calebhylkema/fusion-tracker/docs/nucleo-f446re/pinout.png

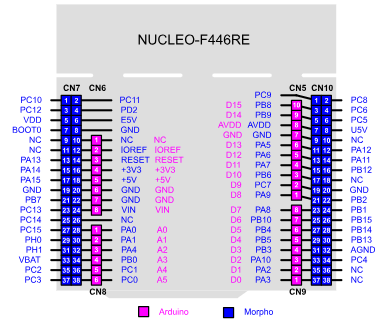
docs/nucleo-f446re/pinout.png
