calebhylkema/fusion-tracker/docs/parts/cam.png

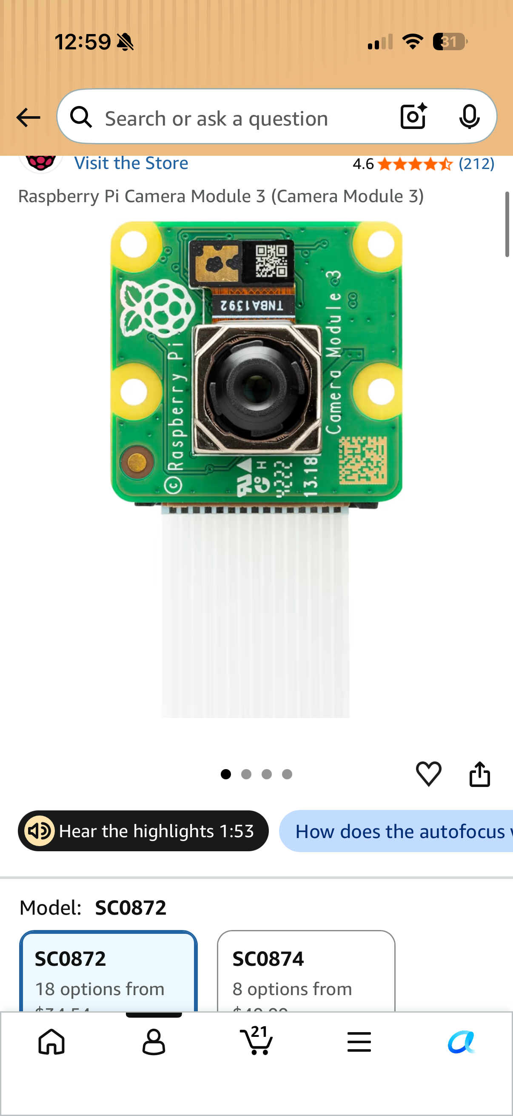
docs/parts/cam.png
