calebhylkema/fusion-tracker/docs/parts/cantx.png

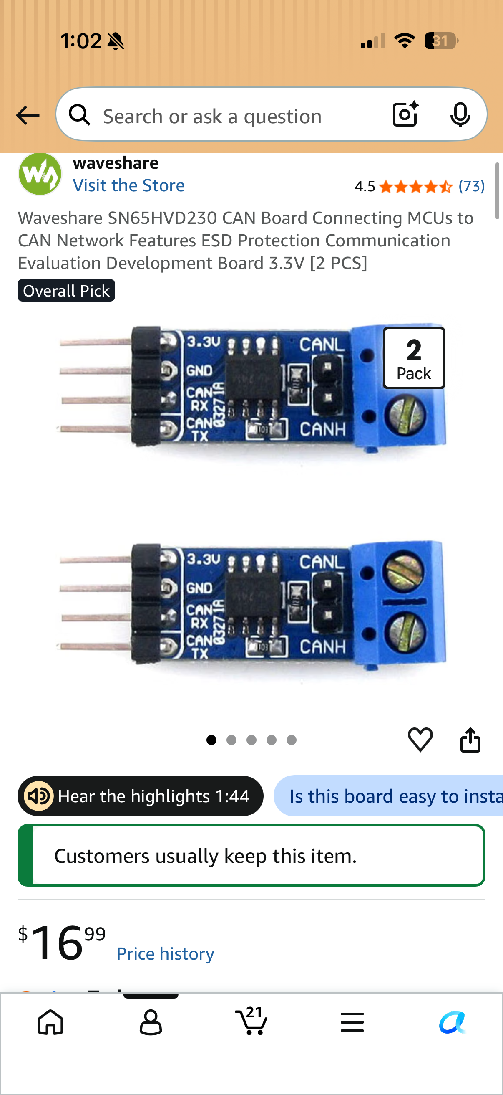
docs/parts/cantx.png
