calebhylkema/fusion-tracker/docs/parts/imu.png

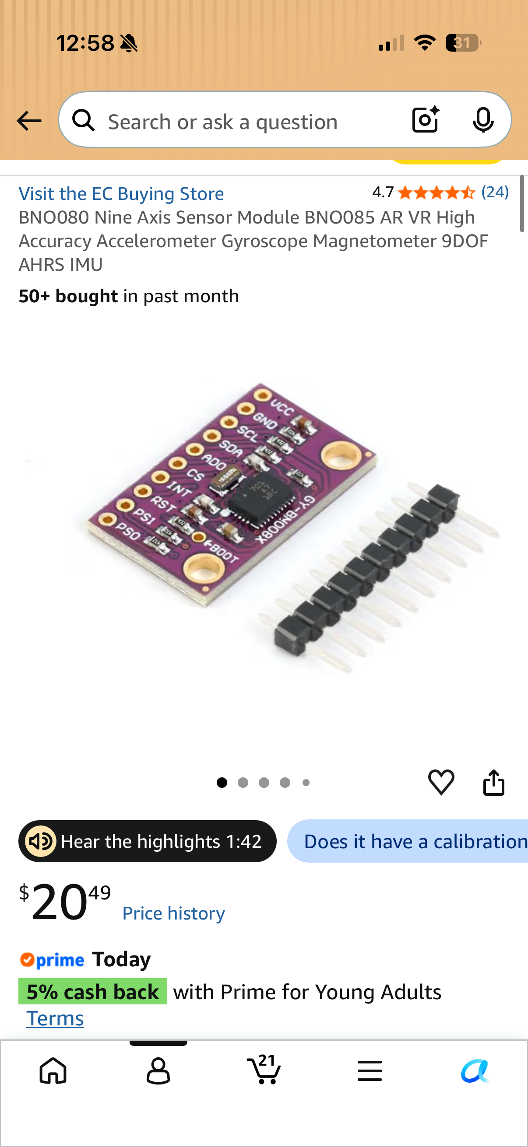
docs/parts/imu.png
