calebhylkema/fusion-tracker/docs/parts/mcu.png

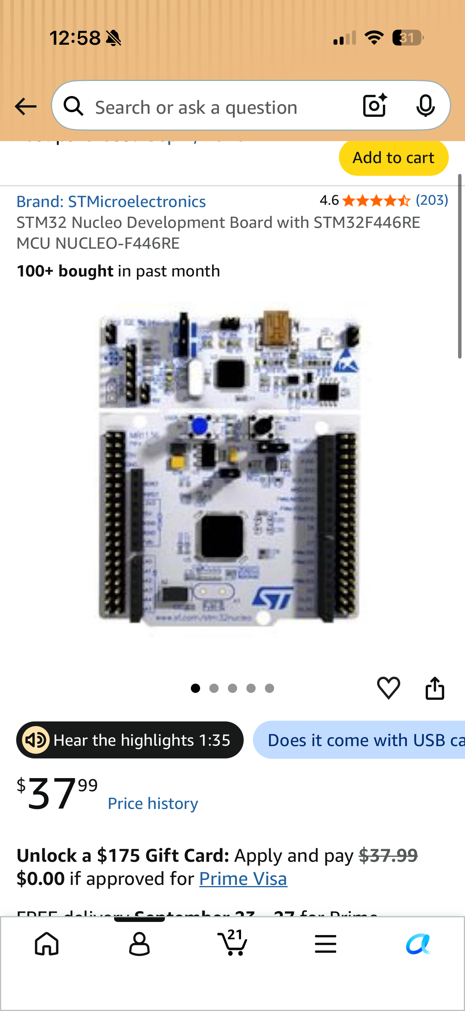
docs/parts/mcu.png
