calebhylkema/fusion-tracker/docs/parts/radar.png

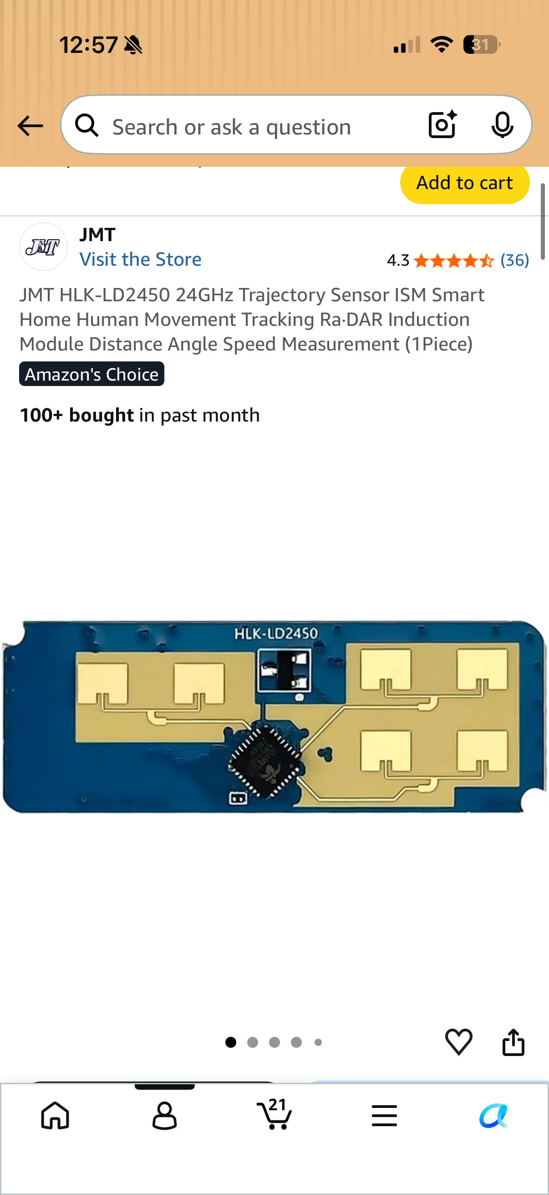
docs/parts/radar.png
