calebhylkema/fusion-tracker/docs/parts/rp5.png

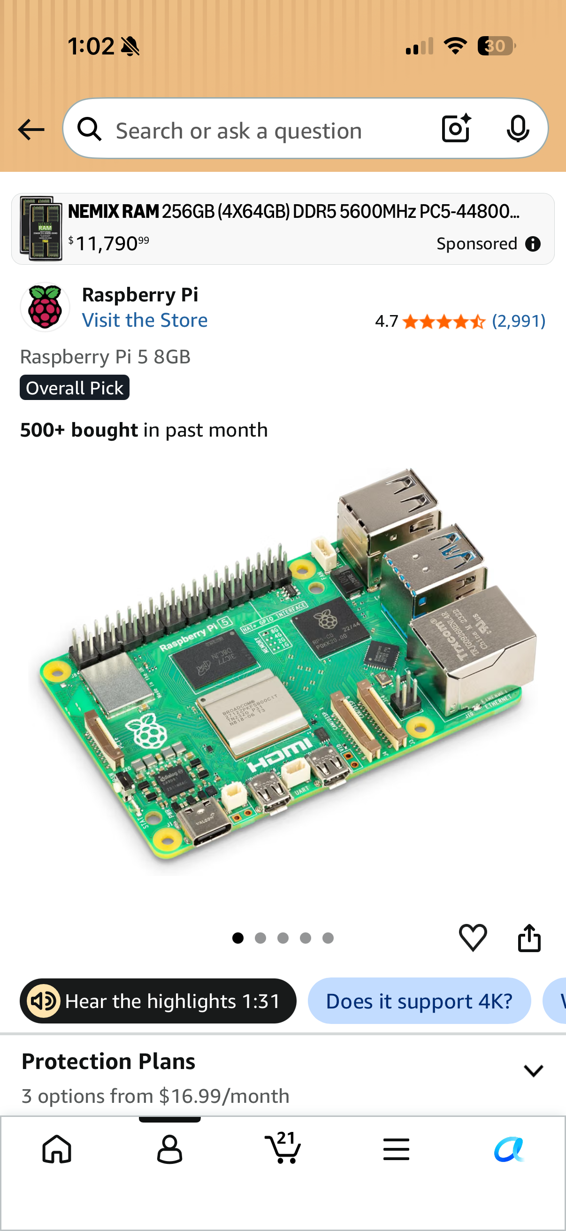
docs/parts/rp5.png
