calebhylkema/fusion-tracker/docs/parts/ttladapter.png

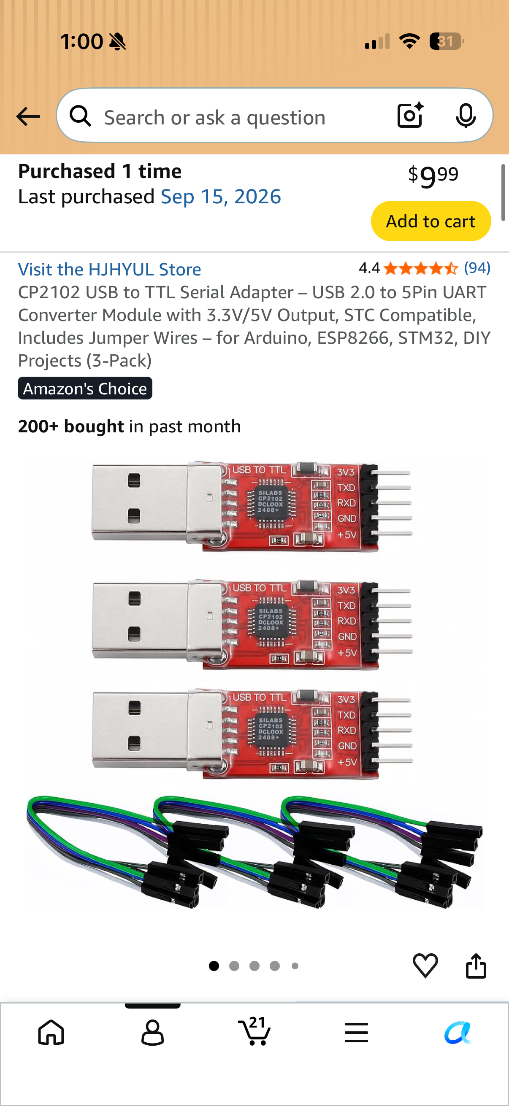
docs/parts/ttladapter.png
