calebhylkema/fusion-tracker/firmware/fusion_tracker_fw/Core/Src/main.c

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
/* Includes ------------------------------------------------------------------*/
#include "main.h"

/* USER CODE BEGIN Includes */

#include <stdio.h>
#include "ld2450.h"
#include "bno085.h"
#include "can_bus.h"
#include "fusion.h"
#include "camera_link.h"

/* USER CODE END Includes */

CAN_HandleTypeDef hcan1;

UART_HandleTypeDef huart1;
UART_HandleTypeDef huart2;
UART_HandleTypeDef huart3;
UART_HandleTypeDef huart6;
DMA_HandleTypeDef hdma_usart1_rx;
DMA_HandleTypeDef hdma_usart3_rx;
DMA_HandleTypeDef hdma_usart6_rx;

void SystemClock_Config(void);
static void MX_GPIO_Init(void);
static void MX_DMA_Init(void);
static void MX_USART2_UART_Init(void);
static void MX_USART1_UART_Init(void);
static void MX_USART3_UART_Init(void);
static void MX_CAN1_Init(void);
static void MX_USART6_UART_Init(void);
/* USER CODE BEGIN 0 */

/* Machine-readable telemetry line for the laptop dashboard:
 * TEL,r0x,r0y,r0ok,r1x,r1y,r1ok,r2x,r2y,r2ok,yawdeg,camdeg,camok,fpxcm,fpycm,fvxcm,fvycm,fok
 * radar x/y in mm; yaw/cam in deg; fused px/py/vx/vy in cm; ok flags 0/1. */
static void telemetry_print(const ld2450_frame_t *r, int16_t yaw_cd,
                            const camera_det_t *cam, const fused_track_t *ft)
{
  printf("TEL");
  for (int t = 0; t < LD2450_MAX_TARGETS; t++)
    printf(",%d,%d,%d", r->target[t].x, r->target[t].y, r->target[t].valid ? 1 : 0);
  printf(",%d,%d,%d", yaw_cd / 100,
         (int)(cam->bearing_rad * 57.2958f), cam->present ? 1 : 0);
  printf(",%d,%d,%d,%d,%d,%lu\r\n",
         (int)(ft->px * 100), (int)(ft->py * 100),
         (int)(ft->vx * 100), (int)(ft->vy * 100), ft->valid ? 1 : 0,
         (unsigned long)camera_rx_bytes());
}

/* USER CODE END 0 */

/**
  * @brief  The application entry point.
  * @retval int
  */
int main(void)
{

  /* MCU Configuration--------------------------------------------------------*/

  /* Reset of all peripherals, Initializes the Flash interface and the Systick. */
  HAL_Init();

  /* Configure the system clock */
  SystemClock_Config();

  /* Initialize all configured peripherals */
  MX_GPIO_Init();
  MX_DMA_Init();
  MX_USART2_UART_Init();
  MX_USART1_UART_Init();
  MX_USART3_UART_Init();
  MX_CAN1_Init();
  MX_USART6_UART_Init();
  /* USER CODE BEGIN 2 */

  setvbuf(stdout, NULL, _IONBF, 0);
  printf("\r\nFusion Tracker booting @ 180 MHz\r\n");
  printf("USART1 radar RX @ 256000...\r\n");
  ld2450_init(&huart1);
  printf("USART3 IMU (BNO085 UART-RVC) @ 115200...\r\n");
  bno085_init(&huart3);
  printf("CAN1 @ 500 kbit/s (loopback self-test)...\r\n");
  can_bus_init(&hcan1);
  printf("EKF fusion (radar + IMU yaw) online\r\n");
  fusion_init();
  printf("USART6 camera link (from Pi) @ 115200...\r\n");
  camera_init(&huart6);

  /* USER CODE END 2 */

  /* Infinite loop */
  /* USER CODE BEGIN WHILE */
  while (1)
  {
    /* USER CODE END WHILE */

    /* USER CODE BEGIN 3 */

    static ld2450_frame_t last_radar;
    static bno085_frame_t last_imu;
    static uint32_t last_print = 0;

    ld2450_frame_t frame;
    static uint32_t radar_tick = 0;
    while (ld2450_process(&frame)) {
      last_radar = frame;
      uint32_t now = HAL_GetTick();
      float dt = radar_tick ? (now - radar_tick) * 0.001f : 0.1f;
      radar_tick = now;
      float yaw = last_imu.yaw * (0.01f * 3.14159265f / 180.0f);  /* centideg -> rad */
      fusion_step(&frame, yaw, dt);
    }

    bno085_frame_t imu;
    while (bno085_process(&imu)) last_imu = imu;          /* keep newest IMU frame */

    static camera_det_t last_cam = {0};
    camera_det_t cam;
    while (camera_process(&cam)) {
      last_cam = cam;
      if (cam.present) {
        float yaw = last_imu.yaw * (0.01f * 3.14159265f / 180.0f);
        fusion_update_camera(cam.bearing_rad + yaw);      /* fuse camera bearing */
      }
    }

    if (HAL_GetTick() - last_print >= 100) {              /* 10 Hz telemetry */
      last_print = HAL_GetTick();
      fused_track_t ft = fusion_track();
      telemetry_print(&last_radar, last_imu.yaw, &last_cam, &ft);

      /* CAN loopback (proven) — kept alive but quieted so the console is readable.
       * Next step: broadcast the real fused track here instead. */
      static uint8_t can_ctr = 0;
      uint8_t tx[8] = { can_ctr++, 0xDE, 0xAD, 0xBE, 0xEF, 0, 0, 0 };
      can_bus_send(0x1F0, tx, 5);
      uint32_t rid; uint8_t rx[8], rlen;
      can_bus_poll(&rid, rx, &rlen);       /* drain FIFO, don't print */
    }
  }
  /* USER CODE END 3 */
}

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
/* USER CODE BEGIN 4 */

int __io_putchar(int ch)
{
  HAL_UART_Transmit(&huart2, (uint8_t *)&ch, 1, HAL_MAX_DELAY);
  return ch;
}

void HAL_UARTEx_RxEventCallback(UART_HandleTypeDef *huart, uint16_t Size)
{
  if (huart->Instance == USART1)
    ld2450_rx_event(Size);
  else if (huart->Instance == USART3)
    bno085_rx_event(Size);
  else if (huart->Instance == USART6)
    camera_rx_event(Size);
}

void HAL_UART_ErrorCallback(UART_HandleTypeDef *huart)
{
  if (huart->Instance == USART1)
    ld2450_error_isr();
  else if (huart->Instance == USART3)
    bno085_error_isr();
  else if (huart->Instance == USART6)
    camera_error_isr();
}

/* USER CODE END 4 */
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
