calebhylkema/fusion-tracker/(commit log)

2026-09-18 Scaffold fusion-tracker repo (Phase 0)
    Repo skeleton, refined spec, requirements + V&V matrix, and setup checklist.
    V1 = LD2450 + camera + IMU fusion (hand-written EKF/IMM); raw-radar swap deferred to V2.
2026-09-19 Add STM32 firmware: Nucleo bringup through radar RX
    - CubeMX/HAL project for NUCLEO-F446RE (180 MHz clock tree)
    - printf retargeted to USART2 (ST-LINK VCP) for debug console
    - USART1 @ 256000 for HLK-LD2450 radar; interrupt RX into ring buffer
    - Confirmed live radar frames (AA FF 03 00 ... 55 CC) on hardware
    - Add NUCLEO-F446RE pinout reference under docs/
2026-09-19 Add LD2450 frame parser with decoded target output
    - Sync on AA FF 03 00 header, validate 55 CC tail (30-byte frame)
    - Sign-magnitude decode of X/Y/speed; matches RBEGamer/HLK-LD2450 reference
    - Per-target output: ID, X, Y, speed, resolution, distance (integer sqrt), valid
    - Ring-buffer fed byte-by-byte from the USART1 RX interrupt
2026-09-19 Refactor radar into reusable ld2450 driver module
    - New Core/{Inc,Src}/ld2450.{h,c}: ring-buffer RX, header-synced parser,
    typed ld2450_frame_t / ld2450_target_t output API
    - main.c now just ld2450_init() + ld2450_process() drain loop, forwards ISRs
    - Behavior unchanged; sets up frame consumption for the EKF later
2026-09-20 Switch radar RX to DMA + idle-line (ReceiveToIdle_DMA)
    - USART1_RX on DMA2 Stream 2; frame delivered per idle event instead of
    one interrupt per byte (~10/s vs ~25,600/s), freeing the CPU for the EKF
    - Driver: ld2450_rx_event() drains the DMA buffer into the ring buffer,
    re-arms; HAL_UARTEx_RxEventCallback forwards from main.c
    - Behavior unchanged; more robust against CPU-busy byte drops
2026-09-21 Add BNO085 IMU (UART-RVC) driver and unified status dashboard
    - New Core/{Inc,Src}/bno085.{h,c}: UART-RVC parser (0xAA 0xAA framing,
    checksum), DMA+idle RX on USART3, yaw/pitch/roll + accel via bno085_frame_t
    - main.c: init both sensors, drain each to latest frame, print one aligned
    fixed-width status line at 5 Hz (IMU angles + 3 radar slots)
    - Three sensors live: radar (10 Hz) + IMU (100 Hz) on one console line
    [bno085.c, bno085.h, fusion_tracker_fw.ioc, main.c]
2026-09-27 Add EKF fusion sim with NEES/NIS validation
    - sim/ekf.py: reference EKF (linear radar + nonlinear camera-bearing update)
    - sim/run_fusion.py: Monte-Carlo scenario, radar-only vs fused RMSE, NEES/NIS
    consistency vs chi-square bounds, trajectory + NEES plots
    - Result: fusion cuts position RMSE 35% (0.218 -> 0.141 m); NEES=3.99/NIS=2.00
    (consistent). Q tuned to 0.2 via the NEES loop.
2026-09-27 Add IMM estimator (CV + coordinated-turn) for maneuvering targets
    - sim/imm.py: IMM with mixing, per-model EKF filtering, mode-probability update,
    moment-matched combination; CV + CT-left + CT-right models
    - sim/ekf.py: generalized to accept arbitrary F/Q (for CT models)
    - sim/run_imm.py: straight->turn->straight scenario, single-CV vs IMM
    - Result: IMM 13% better position RMSE during the turn; mode probs correctly
    switch to the turn model in the maneuver
2026-09-27 Add live (real-time) sim viewers for EKF and IMM
    - sim/live_fusion.py: animated EKF fusion — target, radar measurements,
    radar-only vs fused estimate, 2-sigma covariance ellipse, live error readout
    - sim/live_imm.py: animated IMM — maneuvering target + live mode-probability bars
    - TkAgg interactive windows; headless-smoke-tested
2026-09-28 Add CAN loopback self-test and Pi YOLOv8 person-detection starter
    - firmware Core/{Inc,Src}/can_bus.{h,c}: bxCAN wrapper (accept-all filter,
    TX/RX helpers); main.c runs a 500 kbit/s loopback self-test at 5 Hz
    - pi_app/detection/yolo_detector.py: Picamera2 capture + YOLOv8n person
    detection, prints bbox centers + fps/latency benchmark on the Pi 5
2026-09-28 Add on-board EKF fusion: radar position + IMU yaw -> world-frame track
    - firmware Core/{Inc,Src}/fusion.{h,c}: hand-written single-target EKF
    (CV predict, linear position update), radar mm->m rotated into the world
    frame by the IMU yaw; Q/R seeded from the sim-tuned values
    - main.c drives fusion_step() on each radar frame (dt from tick), prints the
    fused px/py + estimated vx/vy at 5 Hz
    - STM32 now produces a fused track (not just raw sensor prints)
2026-09-28 Camera->STM32 pipeline (Pi side): bearing projection + UART sender
    - pi_app/detection/bearing_projection.py: pixel column -> azimuth (deg) via HFOV
    - pi_app/comms/protocol.py: 6-byte camera frame (hdr, int16 centi-deg, flags, cksum)
    - pi_app/detect_and_send.py: capture -> YOLOv8 -> best person -> bearing -> UART
    - Also fix console: STM32 now prints only the fused px/py/vx/vy at 2 Hz
    [bearing_projection.py, detect_and_send.py, main.c]
2026-09-28 Fuse camera bearing on-board: USART6 receiver + EKF bearing update
    - firmware Core/{Inc,Src}/camera_link.{h,c}: USART6 DMA+idle receiver, parses
    the Pi's 6-byte camera frame (bearing centi-deg, present, checksum)
    - fusion.c: nonlinear camera-bearing update (h=atan2(px,py), Jacobian) added
    - main.c: camera_init on USART6, drains detections into fusion_update_camera
    (bearing + IMU yaw), and shows the live cam bearing in the status line
    - All three sensors now fuse on the STM32: radar + IMU + camera
2026-09-28 Add live hardware dashboard + STM32 telemetry stream
    - main.c: emit compact TEL,... telemetry at 10 Hz (radar targets, IMU yaw,
    camera bearing, fused track) over the debug UART
    - dashboard/live_dashboard.py: laptop bird's-eye view reading the telemetry —
    radar dots, fused track (pos + velocity arrow + trail), camera-bearing ray,
    sensor heading, and a numeric side panel
2026-09-28 Camera link diagnostics: rx byte counter + tolerant dashboard
    - camera_link.c/.h: camera_rx_bytes() counts raw bytes received on USART6
    - main.c telemetry appends the byte count (diagnostic field)
    - dashboard parses telemetry tolerantly (17- or 18-field) so a format change
    never blanks the view; shows "cam bytes" in the panel
2026-09-28 Fix UART RX stall after error (ReceiveToIdle_DMA ORE lock-up)
    A single overrun/noise glitch (e.g. connecting a floating RX line) permanently
    stalled HAL_UARTEx_ReceiveToIdle_DMA because the error ISR re-armed without
    clearing the error flag. Now abort + clear ORE + restart in every UART error
    handler (camera, radar, IMU). Fixes the camera link dying after "bytes for a bit".
    [bno085.c, camera_link.c, detect_and_send.py, ld2450.c]
2026-09-28 Flip camera bearing sign to match radar +X convention
    Camera image left/right was mirrored vs the radar, so the bearing update fought
    the radar in the EKF. Negate pixel_to_bearing so the ray tracks with the radar.
    [bearing_projection.py]
2026-09-28 Stabilize fused track: zero IMU yaw at startup, loosen camera trust, faster coast drop
    - Zero the IMU yaw to boot orientation so the world frame aligns with the radar
    (was rotating by the BNO085's absolute heading -> offset + swing)
    - R_BEARING 2deg -> 6deg so jittery YOLO bearings nudge instead of yank
    - COAST_MAX 2.5s -> 0.8s so a lost track drops instead of flying off
    [fusion.c]
2026-09-28 Add nearest-neighbor gating so fusion ignores radar clutter/ghosts
    The EKF took the first valid radar slot, so a ghost target (clutter/multipath)
    could hijack the track and fling it around. Now associate to the valid target
    nearest the prediction, within a ~1.4 m gate; ignore the rest.
2026-09-28 Add live-dashboard hero shot + bench-setup photo to README
    Real hardware run screenshot (fused track vs radar clutter) up top, and the
    sensor bring-up photo in the Hardware section. Ignore Windows desktop.ini.
